Jannify/KTANE-DIY-Bomb/arduino/src/modules/simon.cpp

#include "common.h"
#include "modules/simon.h"

const unsigned short SIMON_ON_TIME = 500;
const unsigned short SIMON_OFF_TIME = 400;

byte simonSequence[6];
byte simonSequenceLength = 0;
short simonSequenceStep = -1;
bool simonSequenceCallNext = false;
bool simonReadWasPressed = false;
bool simonAcceptButtonInput = false;

void simonInit(byte data0, byte data1)
{
  simonSequenceLength = (data0 & 0b11110000) >> 4;
  simonSequence[0] = (data0 & 0b00001100) >> 2;
  simonSequence[1] = (data0 & 0b00000011);
  simonSequence[2] = (data1 & 0b11000000) >> 6;
  simonSequence[3] = (data1 & 0b00110000) >> 4;
  simonSequence[4] = (data1 & 0b00001100) >> 2;
  simonSequence[5] = (data1 & 0b00000011);

  simonSequenceStep = 0;
  simonSequenceCallNext = true;
  simonAcceptButtonInput = false;
}

void simonLogicLoop()
{
  if (activeModules[4] && !solvedModules[4] && simonSequenceCallNext)
  {
    simonSequenceCallNext = false;
    shiftOutLED(OUTPUT_Clock_SimonSays, 1 << simonSequence[simonSequenceStep]);
    timer.in(SIMON_ON_TIME, handleSimonSequenceOn, (void *)nullptr);
  }
}

void simonSerialWriteLoop()
{
  if (!activeModules[4] || solvedModules[4] || !simonAcceptButtonInput)
  {
    return;
  }

  byte simonButtonPressed = 255;
  if (!digitalRead(INPUT_Simon_Blue))
  {
    simonButtonPressed = 0;
  }
  else if (!digitalRead(INPUT_Simon_Red))
  {
    simonButtonPressed = 1;
  }
  else if (!digitalRead(INPUT_Simon_Yellow))
  {
    simonButtonPressed = 2;
  }
  else if (!digitalRead(INPUT_Simon_Green))
  {
    simonButtonPressed = 3;
  }

  if (simonButtonPressed == 255)
  {
    simonReadWasPressed = false;
  }
  else if (!simonReadWasPressed)
  {
    simonReadWasPressed = true;

    sendSerialData(0x4, simonButtonPressed);

    shiftOutLED(OUTPUT_Clock_SimonSays, 1 << simonButtonPressed);
    timer.in(SIMON_ON_TIME, handleSimonAllOff, (void *)nullptr);
  }
}

void simonPowerOff()
{
  shiftOutLED(OUTPUT_Clock_SimonSays, 0x00);
}

bool handleSimonSequenceOn(void *)
{
  shiftOutLED(OUTPUT_Clock_SimonSays, 0x00);
  timer.in(SIMON_OFF_TIME, handleSimonSequenceOff, (void *)nullptr);
  return false; // to repeat the action - false to stop
}

bool handleSimonSequenceOff(void *)
{
  if (simonSequenceStep >= (simonSequenceLength - 1))
  {
    simonSequenceStep = -1;
    simonAcceptButtonInput = true;
    return false;
  }

  simonSequenceStep++;
  simonSequenceCallNext = true;
  return false; // to repeat the action - false to stop
}

bool handleSimonAllOff(void *)
{
  shiftOutLED(OUTPUT_Clock_SimonSays, 0x00);
  return false; // to repeat the action - false to stop
}
