Jannify/KTANE-DIY-Bomb/(commit log)

2024-03-26 Added raspberry pycharm project files
2024-03-26 Added partly arduino functionality for incoming protocol
2024-03-27 Refactor arduino project to PlatformIO
2024-03-31 Added I2C multipleyer and 3 displays
2024-04-10 Added raspberry webserver and most backend
2024-04-10 Update arduino code to reflect new protocol version
2024-04-12 Added buzzer and first step to not run deactivated modules
    [base.cpp, common.cpp, common.h, frame.cpp, main.cpp]
2024-06-02 Add complete CAD design of bomb and components
    [AllModulesBack.cfg, AllModulesFront.cfg, CompleteBomb.cfg, SingleHull.cfg]
2024-06-02 Change current wiring in README
2024-06-02 Fix bug with " MHz" appending in morse module
    [morse.cpp]
2024-06-16 Update to code and README
    Changed single LED drive to LED Controller
    Updated pin layout for better wiring
2024-06-16 Update to printed BigButton and Morse parts
    [CompleteBomb.cfg]
2024-06-16 Fix sending more than one byte for message index
    [base.cpp, big_button.cpp, main.cpp, memory.cpp, morse.cpp, password.cpp, simon.cpp, wires.cpp]
2024-07-02 fix: Isolated bugs in memory module
    [memory.cpp]
2024-07-02 fix: Isolated bugs in base module
    [common.h]
2024-07-02 add: Use defined constant for multiplexer in frame.cpp
2024-07-02 fix: Isolated bugs in big_button module
    [big_button.cpp, common.h]
2024-07-02 fix: Isolated bugs in simon_says module
    [simon.cpp]
2024-07-02 fix: memoryTriesBuffer in reversed order
    [base.cpp, memory.cpp]
2024-07-02 fix: solvedModulesLed pin order
    [frame.cpp]
2024-07-02 fix: Change module and multiplexer ordering
    [common.h]
2024-07-02 fix: Reorder pin layout for password and big_button buttons
    [common.h, main.cpp]
2024-07-02 change: Reduce flickering for controller driven LEDs
2024-07-03 fix: Isolated bugs in morse module
    [common.h, main.cpp, morse.cpp]
2024-07-03 add: controlling white indicator led
2024-07-05 add: SolidEdge files for Arduino and Pi holder
2024-07-05 fix: A LOT of bugfixing
    [base.cpp, big_button.cpp, common.cpp, common.h, frame.cpp]
2024-07-08 fix: Clock display and buzzer not working
    [base.cpp, common.h]
2024-07-08 fix: Bomb.UpdateSolvedModule() targeting right module
    [common.cpp, main.cpp]
2024-07-08 fix: Resseting of IndicatorLED
    [frame.cpp, main.cpp]
2024-07-09 add: split activeModules and solvedModules to separate state
    [common.cpp, common.h, morse.cpp]
2024-07-09 fix: big_button secondsLeft parsing
    [base.cpp, big_button.cpp]
2024-07-09 fix: arduino display clear on power on
    [big_button.cpp, frame.cpp, main.cpp, morse.cpp, password.cpp]
2024-07-09 fix: Memory module backend bugs and digit shutdown
    [memory.cpp]
2024-07-10 fix: multiple bugs in SimonSays module
    [main.cpp, simon.cpp]
2024-07-12 fix: reenable serialNumber and fix generating it too long
    [common.h, frame.cpp]
2024-07-12 add: Explosion handling, reenable tries and fixed maxTries display
    [base.cpp, common.cpp, common.h, main.cpp]
2024-07-12 add: Logging framework and display on website
2024-07-13 quick fix password not working
    [main.cpp, password.cpp]
2025-07-14 update: final prototype version
    [AllModulesBack.cfg, AllModulesFront.cfg, CompleteBomb.cfg]
2025-07-18 update: improved prototype version
2025-07-18 fix: sending 2 serial numbers less
    [common.cpp, common.h, frame.cpp, main.cpp]
